Crist002/BANCO_CARGA/README.md

# BANCO_CARGA
Banco de Carga Resisitivo
Link de SD:
https://naylampmechatronics.com/blog/38_tutorial-arduino-y-memoria-sd-y-micro-sd.html
Link Calcular CRC:
https://www.lammertbies.nl/comm/info/crc-calculation

https://aprendiendoarduino.wordpress.com/tag/avanzado/
