Crist002/BANCO_CARGA/Programaciones/Banco_1.15/Descripcion.txt

Se guardan en la SD los valores de tension y corriente de los canales A, B y C
Se implemento el RTC DS3231 que se comunica por I2C como el anterior
