Crist002/BANCO_CARGA/LOGICA BANCO DE CARGA.xlsx

Sheet: LOGICA
PASO |  | KW |  |  |  | NUMERO DE RELÉ |  |  |  |  |  |  | PISO 1 |  | PISO 2 |  | PISO 3 |  | PISO 4
 |  |  | 15 | 15 | 7.5 | 15 | 15 | 15 | 15 | 15 | 15
1 | 0.00 | 0.00 | K1 | K2 | K3 | K4 | K5 | K6 | K7 | K8 | K9 | K1 | K2 | K3 | K4 | K5 | K6 | K7 | K8 | K9
2 | 7.50 | 7.50 | 0 | 0 | 1 | 0 | 0 | 0 | 0 | 0 | 0 | 0.00 | 0.00 | 7.50 | 0.00 | 0.00 | 0.00 | 0.00 | 0.00 | 0.00 | 7.50
3 | 15.00 | 15.00 | 0 | 0 | 0 | 0 | 0 | 1 | 0 | 0 | 0 | 0.00 | 0.00 | 0.00 | 0.00 | 0.00 | 15.00 | 0.00 | 0.00 | 0.00 | 15.00
4 | 22.50 | 22.50 | 0 | 0 | 1 | 0 | 0 | 0 | 0 | 0 | 1 | 0.00 | 0.00 | 7.50 | 0.00 | 0.00 | 0.00 | 0.00 | 0.00 | 15.00 | 22.50
5 | 30.00 | 30.00 | 0 | 0 | 0 | 0 | 0 | 1 | 0 | 1 | 0 | 0.00 | 0.00 | 0.00 | 0.00 | 0.00 | 15.00 | 0.00 | 15.00 | 0.00 | 30.00
6 | 37.50 | 37.50 | 0 | 0 | 1 | 0 | 0 | 0 | 1 | 0 | 1 | 0.00 | 0.00 | 7.50 | 0.00 | 0.00 | 0.00 | 15.00 | 0.00 | 15.00 | 37.50
7 | 45.00 | 45.00 | 0 | 1 | 0 | 1 | 0 | 0 | 0 | 1 | 0 | 0.00 | 15.00 | 0.00 | 15.00 | 0.00 | 0.00 | 0.00 | 15.00 | 0.00 | 45.00
8 | 52.50 | 52.50 | 0 | 0 | 1 | 0 | 1 | 0 | 1 | 0 | 1 | 0.00 | 0.00 | 7.50 | 0.00 | 15.00 | 0.00 | 15.00 | 0.00 | 15.00 | 52.50
9 | 60.00 | 60.00 | 0 | 1 | 0 | 1 | 0 | 1 | 0 | 1 | 0 | 0.00 | 15.00 | 0.00 | 15.00 | 0.00 | 15.00 | 0.00 | 15.00 | 0.00 | 60.00
10 | 67.50 | 67.50 | 0 | 1 | 1 | 0 | 1 | 0 | 1 | 0 | 1 | 0.00 | 15.00 | 7.50 | 0.00 | 15.00 | 0.00 | 15.00 | 0.00 | 15.00 | 67.50
11 | 75.00 | 75.00 | 0 | 1 | 0 | 1 | 1 | 1 | 0 | 1 | 0 | 0.00 | 15.00 | 0.00 | 15.00 | 15.00 | 15.00 | 0.00 | 15.00 | 0.00 | 75.00
12 | 82.50 | 82.50 | 0 | 0 | 1 | 1 | 1 | 1 | 1 | 0 | 1 | 0.00 | 0.00 | 7.50 | 15.00 | 15.00 | 15.00 | 15.00 | 0.00 | 15.00 | 82.50
13 | 90.00 | 90.00 | 1 | 1 | 0 | 1 | 1 | 0 | 1 | 1 | 0 | 15.00 | 15.00 | 0.00 | 15.00 | 15.00 | 0.00 | 15.00 | 15.00 | 0.00 | 90.00
14 | 97.50 | 97.50 | 0 | 1 | 1 | 1 | 1 | 1 | 1 | 0 | 1 | 0.00 | 15.00 | 7.50 | 15.00 | 15.00 | 15.00 | 15.00 | 0.00 | 15.00 | 97.50
15 | 105.00 | 105.00 | 0 | 1 | 0 | 1 | 1 | 1 | 1 | 1 | 1 | 0.00 | 15.00 | 0.00 | 15.00 | 15.00 | 15.00 | 15.00 | 15.00 | 15.00 | 105.00
16 | 112.50 | 112.50 | 1 | 1 | 1 | 1 | 1 | 1 | 1 | 1 | 0 | 15.00 | 15.00 | 7.50 | 15.00 | 15.00 | 15.00 | 15.00 | 15.00 | 0.00 | 112.50
17 | 120.00 | 120.00 | 1 | 1 | 0 | 1 | 1 | 1 | 1 | 1 | 1 | 15.00 | 15.00 | 0.00 | 15.00 | 15.00 | 15.00 | 15.00 | 15.00 | 15.00 | 120.00

Sheet: Logica Clic
PASO |  | KW |  |  |  | NUMERO DE RELÉ |  |  |  |  |  |  | PISO 1 |  | PISO 2 |  | PISO 3 |  | PISO 4
 |  |  | 15 | 15 | 7.5 | 15 | 15 | 15 | 15 | 15 | 15
1 | 0.00 | 0.00 | K1 | K2 | K3 | K4 | K5 | K6 | K7 | K8 | K9 | K1 | K2 | K3 | K4 | K5 | K6 | K7 | K8 | K9
2 | 7.50 | 7.50 | 0 | 0 | 1 | 0 | 0 | 0 | 0 | 0 | 0 | 0.00 | 0.00 | 7.50 | 0.00 | 0.00 | 0.00 | 0.00 | 0.00 | 0.00 | 7.50
3 | 15.00 | 15.00 | 0 | 0 | 0 | 0 | 0 | 1 | 0 | 0 | 0 | 0.00 | 0.00 | 0.00 | 0.00 | 0.00 | 15.00 | 0.00 | 0.00 | 0.00 | 15.00
4 | 22.50 | 22.50 | 0 | 0 | 1 | 1 | 0 | 0 | 0 | 0 | 0 | 0.00 | 0.00 | 7.50 | 15.00 | 0.00 | 0.00 | 0.00 | 0.00 | 0.00 | 22.50
5 | 30.00 | 30.00 | 0 | 0 | 0 | 1 | 0 | 1 | 0 | 0 | 0 | 0.00 | 0.00 | 0.00 | 15.00 | 0.00 | 15.00 | 0.00 | 0.00 | 0.00 | 30.00
6 | 37.50 | 37.50 | 0 | 0 | 1 | 0 | 0 | 0 | 0 | 1 | 1 | 0.00 | 0.00 | 7.50 | 0.00 | 0.00 | 0.00 | 0.00 | 15.00 | 15.00 | 37.50
7 | 45.00 | 45.00 | 0 | 1 | 0 | 1 | 0 | 1 | 0 | 0 | 0 | 0.00 | 15.00 | 0.00 | 15.00 | 0.00 | 15.00 | 0.00 | 0.00 | 0.00 | 45.00
8 | 52.50 | 52.50 | 0 | 0 | 1 | 1 | 0 | 0 | 0 | 1 | 1 | 0.00 | 0.00 | 7.50 | 15.00 | 0.00 | 0.00 | 0.00 | 15.00 | 15.00 | 52.50
9 | 60.00 | 60.00 | 0 | 1 | 0 | 1 | 0 | 1 | 1 | 0 | 0 | 0.00 | 15.00 | 0.00 | 15.00 | 0.00 | 15.00 | 15.00 | 0.00 | 0.00 | 60.00
10 | 67.50 | 67.50 | 0 | 1 | 1 | 0 | 0 | 1 | 0 | 1 | 1 | 0.00 | 15.00 | 7.50 | 0.00 | 0.00 | 15.00 | 0.00 | 15.00 | 15.00 | 67.50
11 | 75.00 | 75.00 | 1 | 1 | 0 | 1 | 1 | 1 | 0 | 0 | 0 | 15.00 | 15.00 | 0.00 | 15.00 | 15.00 | 15.00 | 0.00 | 0.00 | 0.00 | 75.00
12 | 82.50 | 82.50 | 0 | 0 | 1 | 1 | 1 | 1 | 0 | 1 | 1 | 0.00 | 0.00 | 7.50 | 15.00 | 15.00 | 15.00 | 0.00 | 15.00 | 15.00 | 82.50
13 | 90.00 | 90.00 | 1 | 1 | 0 | 1 | 1 | 1 | 1 | 0 | 0 | 15.00 | 15.00 | 0.00 | 15.00 | 15.00 | 15.00 | 15.00 | 0.00 | 0.00 | 90.00
14 | 97.50 | 97.50 | 0 | 1 | 1 | 1 | 0 | 1 | 1 | 1 | 1 | 0.00 | 15.00 | 7.50 | 15.00 | 0.00 | 15.00 | 15.00 | 15.00 | 15.00 | 97.50
15 | 105.00 | 105.00 | 0 | 1 | 0 | 1 | 1 | 1 | 1 | 1 | 1 | 0.00 | 15.00 | 0.00 | 15.00 | 15.00 | 15.00 | 15.00 | 15.00 | 15.00 | 105.00
16 | 112.50 | 112.50 | 0 | 1 | 1 | 1 | 1 | 1 | 1 | 1 | 1 | 0.00 | 15.00 | 7.50 | 15.00 | 15.00 | 15.00 | 15.00 | 15.00 | 15.00 | 112.50
17 | 120.00 | 120.00 | 1 | 1 | 0 | 1 | 1 | 1 | 1 | 1 | 1 | 15.00 | 15.00 | 0.00 | 15.00 | 15.00 | 15.00 | 15.00 | 15.00 | 15.00 | 120.00

Sheet: Conectores
Item | Cantidad | Codigo | Descripción | P Unit | Subtot
1 | 4 | G400BH-VC | BASE HEMBRA UNIP. 400 AMP. VARIOS COLORES | 36.52 | 146.08
2 | 4 | G400PM-VC | PROLONGACION MACHO UNIP. 400 AMP. VARIOS COLORES | 50.5 | 202
3 | 4 | TAPA-M | TAPA PARA FICHAS Y BASES MACHOS | 3.67 | 14.68
 |  |  |  | U$S | 362.76
 |  |  |  | $ | 16324.2
 |  |  |  | Con IVA | 19752.282

Sheet: Hoja1
Paso Nº | Potencia
1 | 0
2 | 7.5
3 | 15
4 | 22.5
5 | 30
6 | 37.5
7 | 45 | -2100 | 750 |  | -1350 |  | 600
8 | 52.5 | -2100 | 750 |  | -1350 |  | -210
9 | 60 | -1800 | 860 | 860 | -80 |  | -210
10 | 67.5
11 | 75 |  |  |  |  |  | 180
12 | 82.5 |  | 900 | 900 |  | 1800
13 | 90 |  | 750 | 750 |  | 1500
14 | 97.5
15 | 105
16 | 112.5
17 | 120
Potencia Inicial
Potencia Final
Tiempo entre pasos
Inicio de test
Fin de test
Entradas | Arriba
 | Abajo
 | Enter
 | Escape
 | Sensor de Flujo de aire
Salidas | K1
 | K2
 | K3
 | K4
 | K5
 | K6
 | K7
 | K8
 | K9
