Crist002/BANCO_CARGA/Programaciones/Banco_1.17/Esquematico Banco 1.17.pdf

## GND

# VCC PROCESSE

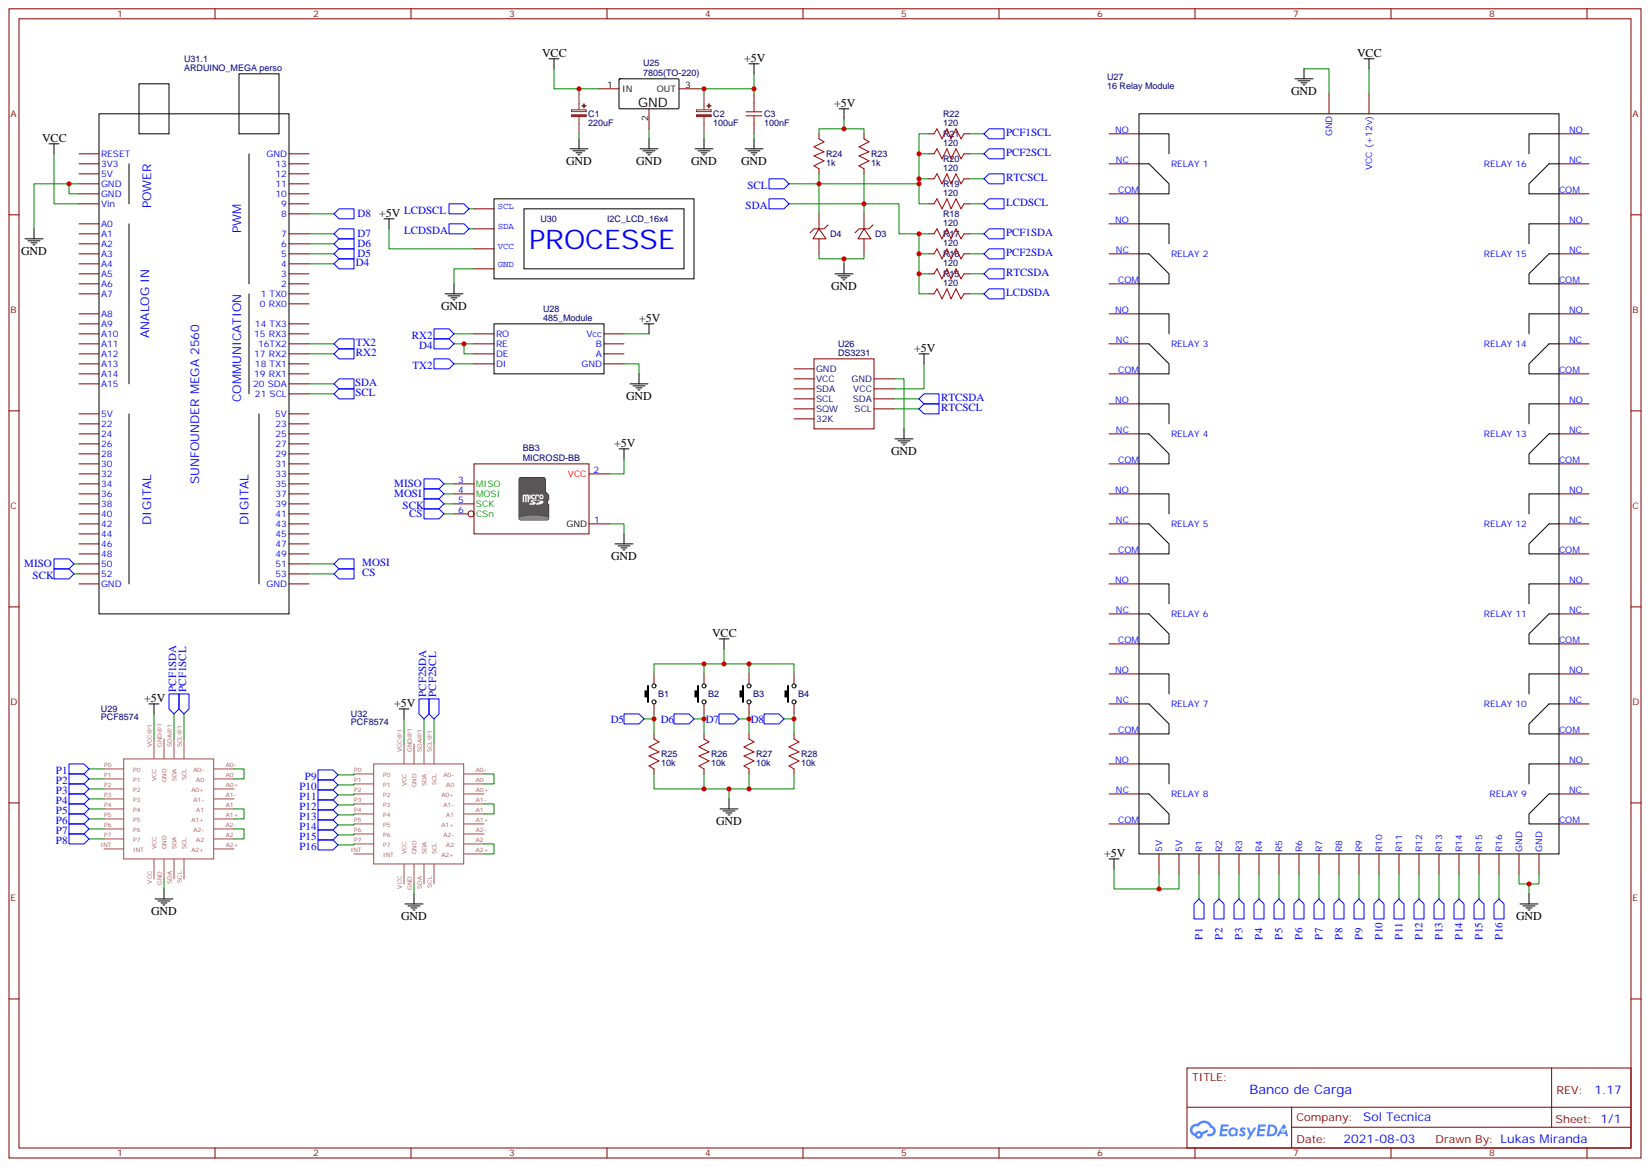
[picture p1: page 1]

Drawn By: Lukas Miranda
