Crist002/BANCO_CARGA/Programaciones/Banco_1.16/Esquematico Banco 1.16.pdf

LM2596

# VCC PROCESSE

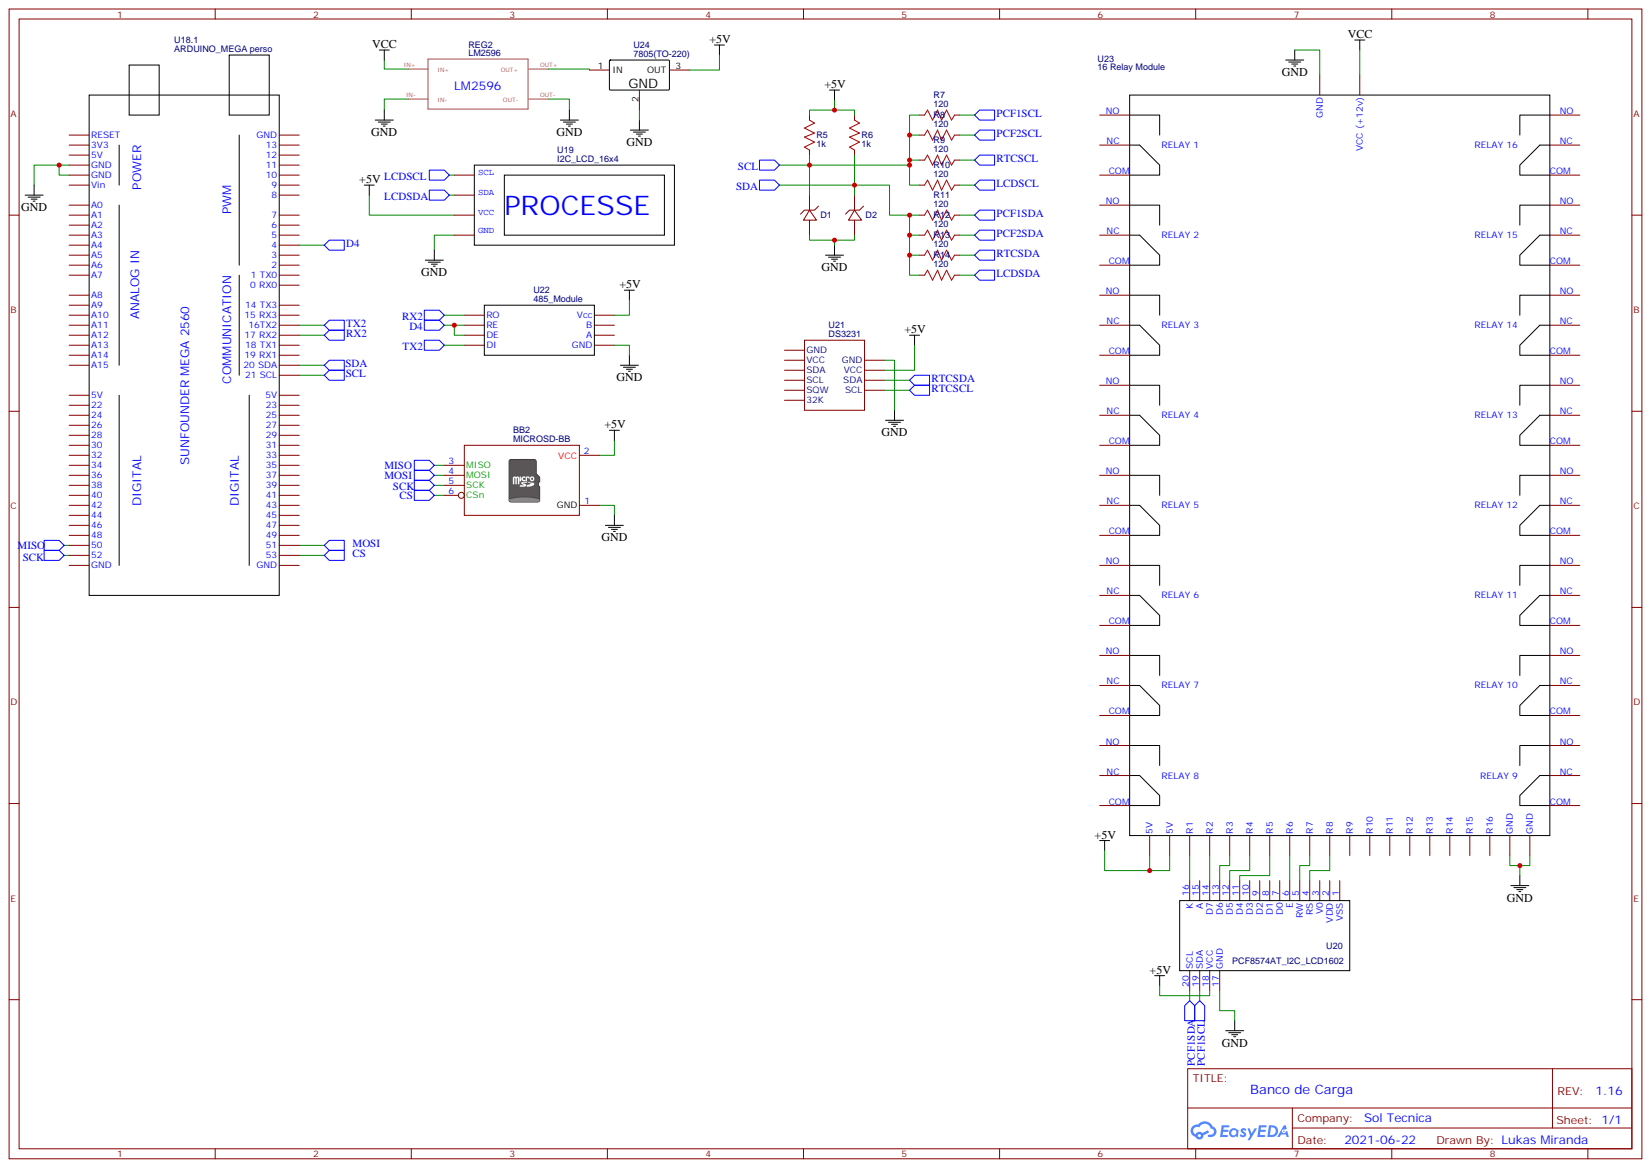
[picture p2: page 1]

GND 17 VCC 18 SDA 19 SCL 20

Drawn By: Lukas Miranda
