Crist002/BANCO_CARGA/Programaciones/Banco_1.14/Esquematico Banco 1.14.pdf

# VCC PROCESSE SDA

LM2596

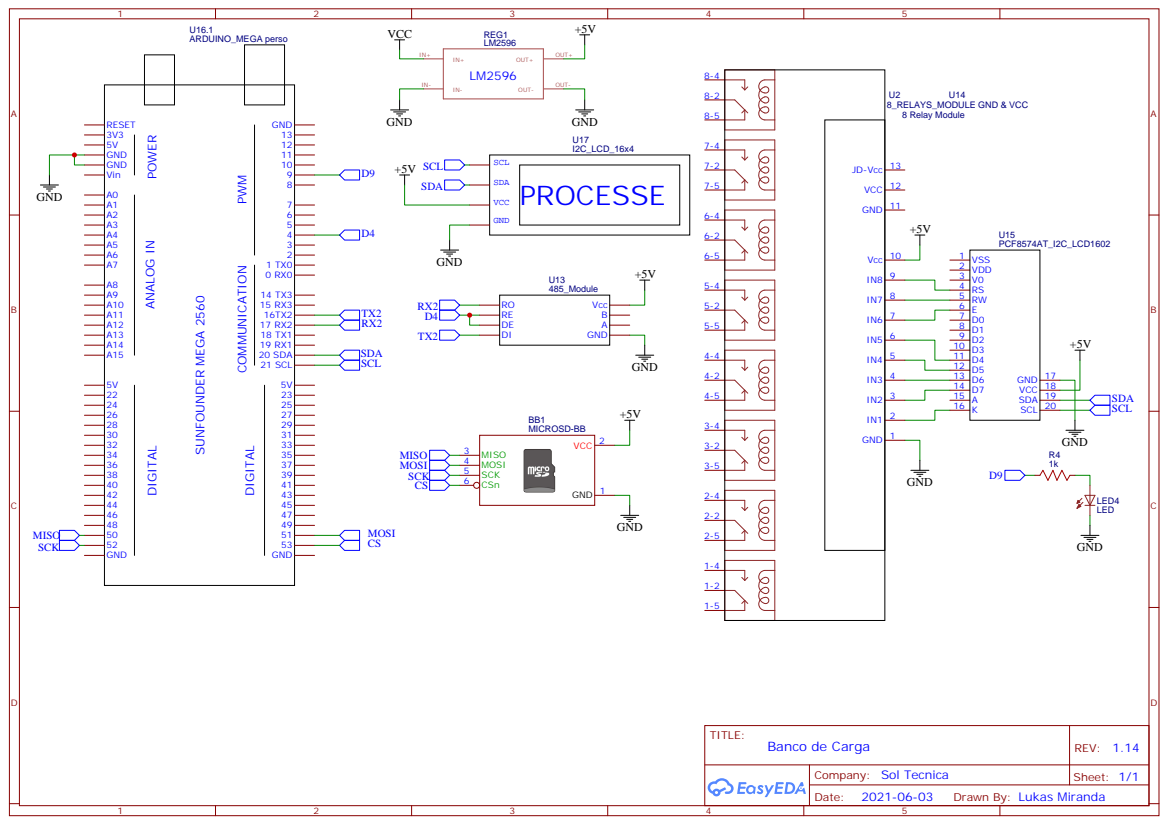
[picture p3: page 1]

Drawn By: Lukas Miranda
