Crist002/BANCO_CARGA/Programaciones/Banco_1.13/Esquematico Banco 1.13.pdf

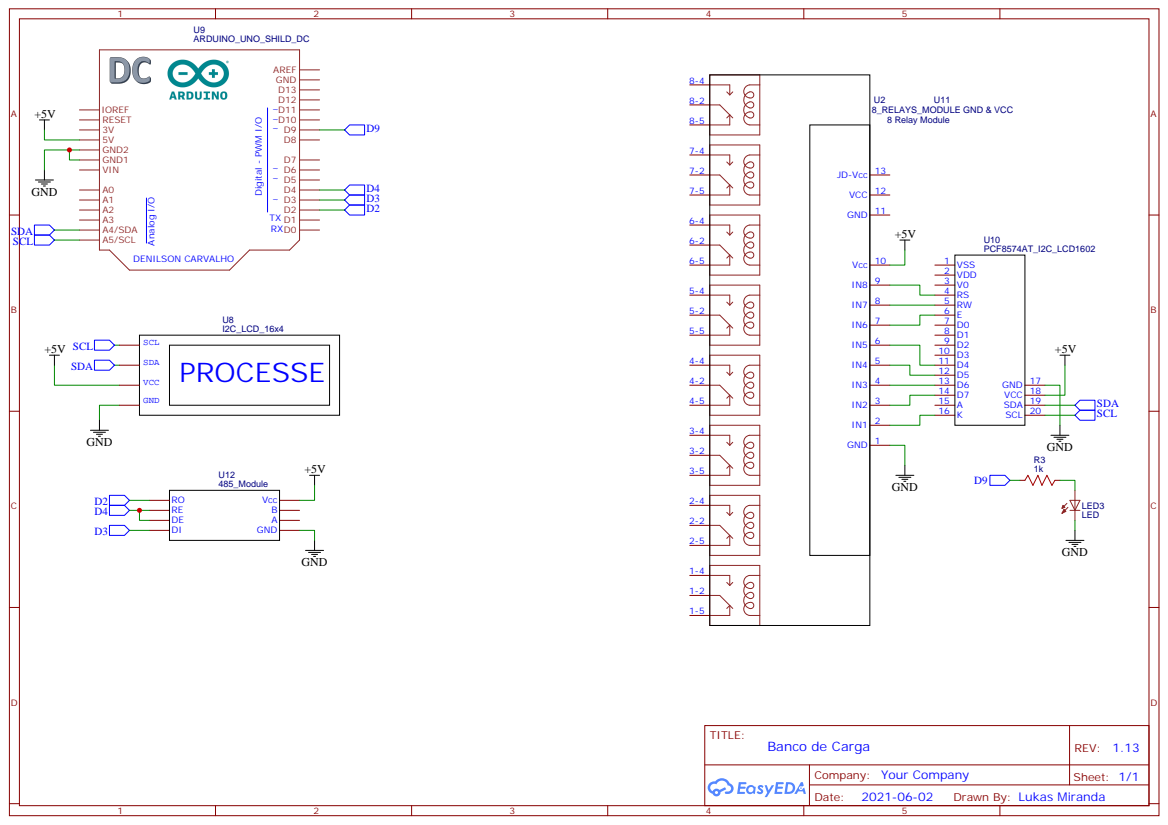
[picture p4: page 1]

Drawn By: Lukas Miranda
