Crist002/BANCO_CARGA/Programaciones/Banco_1.11/Esquematico Banco 1.11.pdf

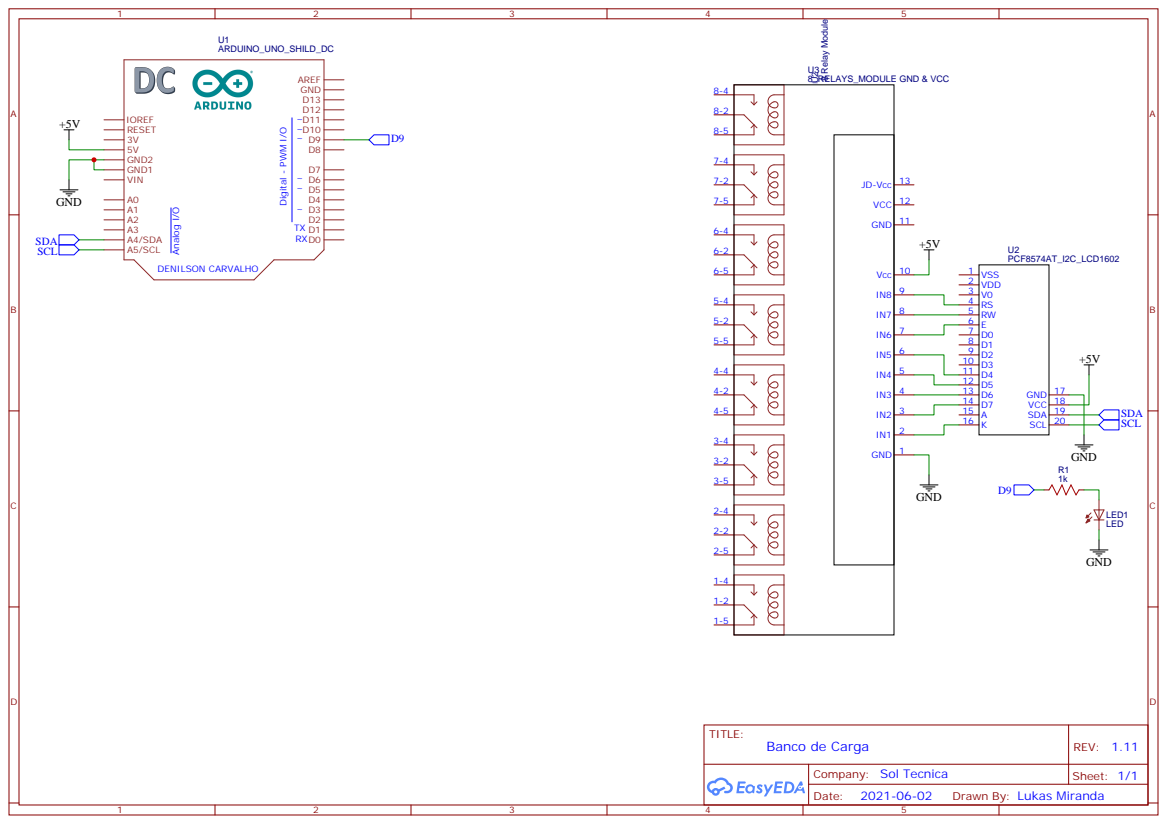
[picture p5: page 1]

Drawn By: Lukas Miranda
