Crist002/BANCO_CARGA/Programaciones/Banco_1.12/Esquematico Banco 1.12.pdf

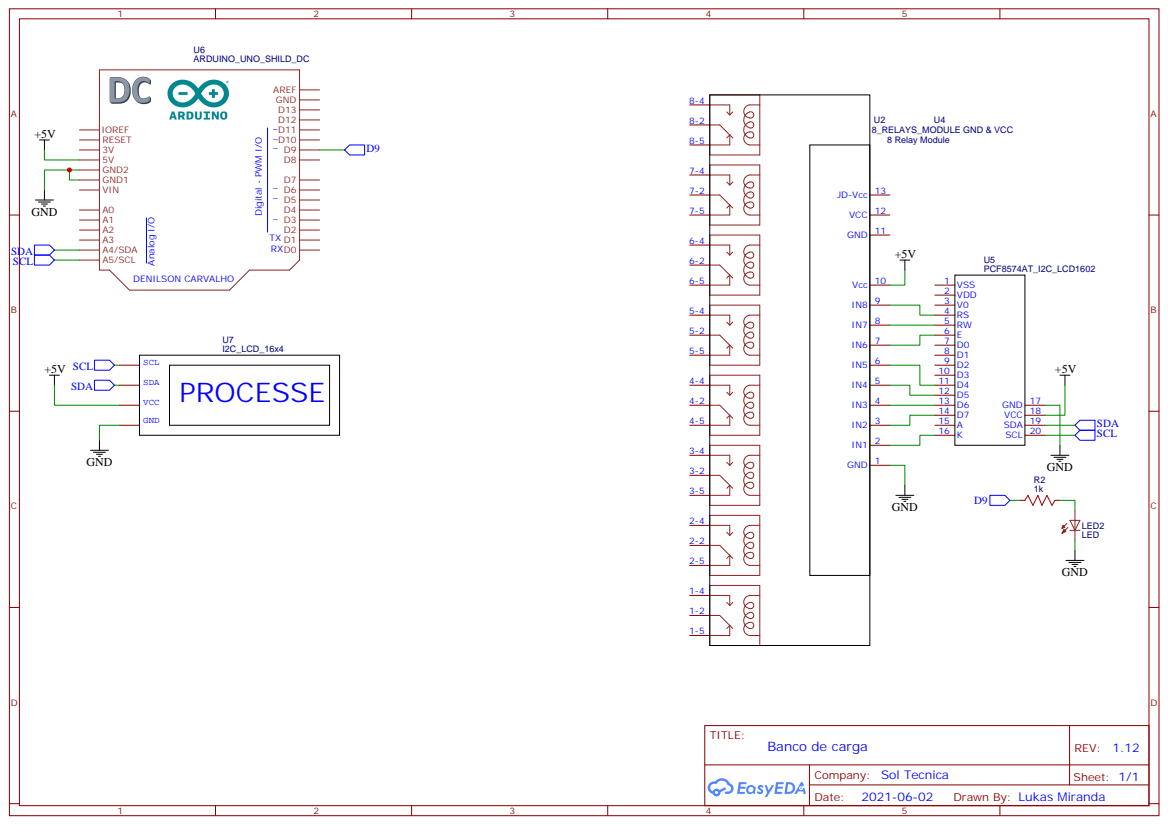
[picture p6: page 1]

Drawn By: Lukas Miranda
