Crist002/BANCO_CARGA/Programaciones STM32/BANCO_CARGA_STM_1.0/BANCO_CARGA_STM_1.0.ioc

Mcu.UserName=STM32F103C8Tx
PA13.Signal=SYS_JTMS-SWDIO
PA14.Signal=SYS_JTCK-SWCLK
PA15.GPIO_Label=entrada3
PA15.Signal=GPIO_Input
PA5.Signal=SPI1_SCK
PA6.Signal=SPI1_MISO
PA7.Signal=SPI1_MOSI
PB0.Signal=GPIO_Output
PB10.Signal=USART3_TX
PB11.Signal=USART3_RX
PB15.GPIO_Label=entrada4
PB15.Signal=GPIO_Input
PB3.GPIO_Label=entrada2
PB3.Signal=GPIO_Input
PB4.GPIO_Label=entrada1
PB4.Signal=GPIO_Input
PB6.Signal=I2C1_SCL
PB7.Signal=I2C1_SDA
PB9.GPIO_Label=modbus
PB9.Signal=GPIO_Output
PD0-OSC_IN.Signal=RCC_OSC_IN
PD1-OSC_OUT.Signal=RCC_OSC_OUT
