Crist002/BANCO_CARGA/Programaciones STM32/BANCO_CARGA_STM_1.0/Core/Inc/main.h

#define entrada4_Pin GPIO_PIN_15
#define entrada4_GPIO_Port GPIOB
#define entrada3_Pin GPIO_PIN_15
#define entrada3_GPIO_Port GPIOA
#define entrada2_Pin GPIO_PIN_3
#define entrada2_GPIO_Port GPIOB
#define entrada1_Pin GPIO_PIN_4
#define entrada1_GPIO_Port GPIOB
#define modbus_Pin GPIO_PIN_9
#define modbus_GPIO_Port GPIOB
