Crist002/BANCO_CARGA/Programaciones/RTC_obtener_tiempo/RTC_obtener_tiempo.ino

#include <Wire.h>
#include "RTClib.h"

RTC_DS1307 rtc;

byte segundo,minuto,hora,dia,mes;
int anio; //variable año
DateTime HoraFecha;

void setup () {
  Serial.begin(9600);
  rtc.begin(); //Inicializamos el RTC
  
}

void loop () {
    HoraFecha = rtc.now(); //obtenemos la hora y fecha actual
    
    segundo=HoraFecha.second();
    minuto=HoraFecha.minute();
    hora=HoraFecha.hour();
    dia=HoraFecha.day();
    mes=HoraFecha.month();
    anio=HoraFecha.year();

    //Enviamos por el puerto serie la hora y fecha.
    Serial.print("hora = ");
    Serial.print(hora);
    Serial.print(":");
    Serial.print(minuto);
    Serial.print(":");
    Serial.print(segundo);
    Serial.print("  Fecha = ");
    Serial.print(dia);
    Serial.print("/");
    Serial.print(mes);
    Serial.print("/");
    Serial.print(anio);
    Serial.println();
    delay(1000);
}
