Crist002/BANCO_CARGA/Programaciones STM32/BANCO_CARGA_STM_1.0/Core/Inc/i2c-lcd.h

#include "stm32f1xx_hal.h"
#include "inttypes.h"

void lcd_init (void);   // initialize lcd

void lcd_send_cmd (char cmd);  // send command to the lcd

void lcd_send_data (char data);  // send data to the lcd

void lcd_send_string (char *str);  // send string to the lcd

void lcd_put_cur(int row, int col);  // put cursor at the entered position row (0 or 1), col (0-15);

void lcd_clear (void);

void lcd_create_character  (uint8_t location, const char *charmap);

void lcd_write(uint8_t value);

void lcd_mostrar (uint8_t data);
