Crist002/BANCO_CARGA/(notices)

Notices in the files:
Programaciones STM32/BANCO_CARGA_STM_1.0/Core/Inc/main.h:
© Copyright (c) 2021 STMicroelectronics.
All rights reserved.
This software component is licensed by ST under BSD 3-Clause license,
the "License"; You may not use this file except in compliance with the
License. You may obtain a copy of the License at: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
(C) COPYRIGHT STMicroelectronics *****END OF FILE
